SergioPDhe/SergioPico/fabrication/SergioPico_BOM.xlsx

Comment | Designator | Footprint | JLBPCB part #
100n | C1 | Capacitor_SMD:C_0603_1608Metric_Pad1.08x0.95mm_HandSolder | C83060
B5819W | D2 | Diode_SMD:D_SOD-123 | C8598
SS8050 | Q1 | Package_TO_SOT_SMD:SOT-23_Handsoldering | C2150
220 | R1 | Resistor_SMD:R_0603_1608Metric_Pad0.98x0.95mm_HandSolder | C22962
