SergioPDhe/SergioPico/SergioPico_USB/fabrication/USB_BOM.xlsx

Comment | Designator | Footprint | JLBPCB part #
B5819W | D1 | Diode_SMD:D_SOD-123 | C8598
XUNPU TYPEC-1103-BRP24 | J1 | Sergio_footprints:Xunpu C2856665 USBC Straddle Mount | C2856665
5.1k | R1, R2 | Resistor_SMD:R_0603_1608Metric | C23186
