SergioPDhe/SergioPico/Chassis/SergioPico/Rumble.step

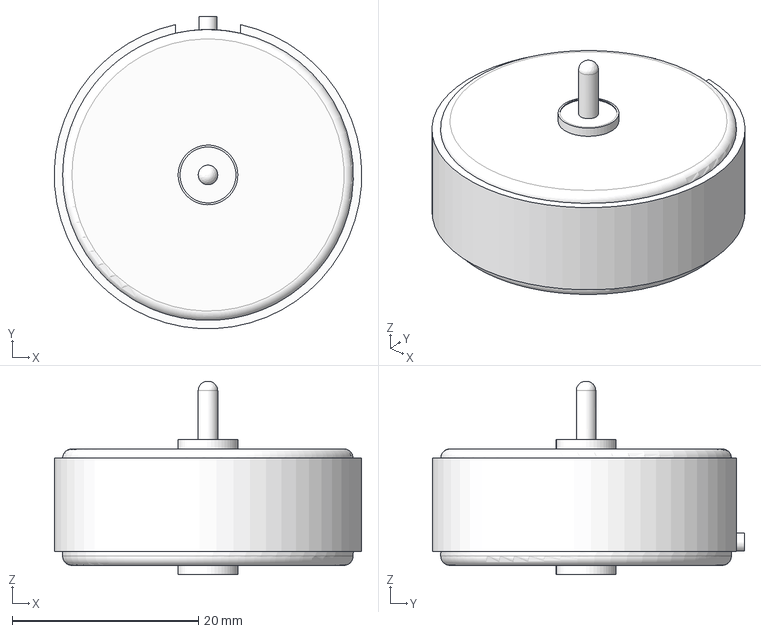
[picture p1: CAD file, 2023-11-24]
Chassis/SergioPico/Rumble.step
33.0 x 33.5 x 20.8 mm
