SergioPDhe/SergioPico/fabrication/keycap_20.5x10_f1_resin.STL

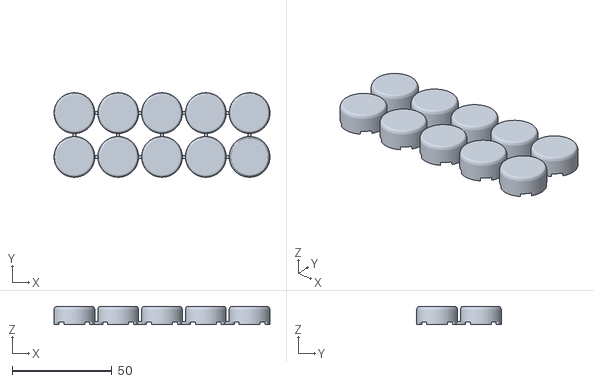
[picture p2: CAD file, 2023-11-24]
fabrication/keycap_20.5x10_f1_resin.STL
108.5 x 42.5 x 9.23
