SergioPDhe/SergioPico/SergioPico_PCB.step

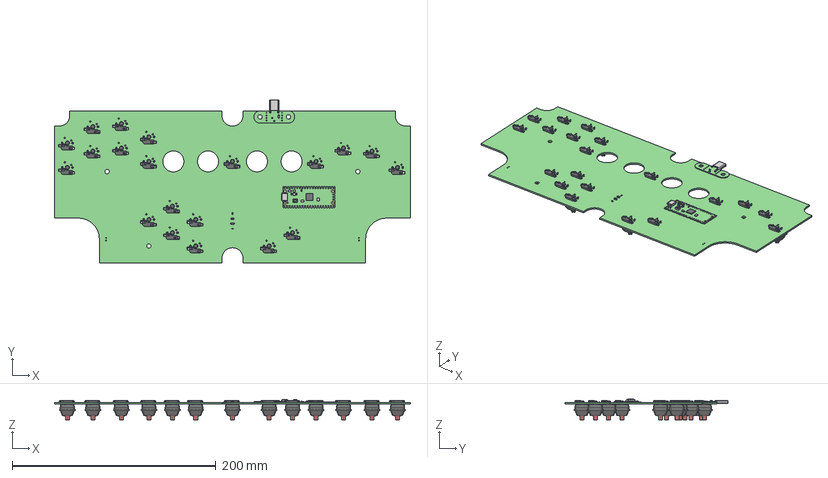
[picture p3: CAD file, 2023-11-24]
SergioPico_PCB.step
349.3 x 159.9 x 20.1 mm
SergioPico PCB
