SergioPDhe/SergioPico/SergioPico_USB/SergioPico_USB.step

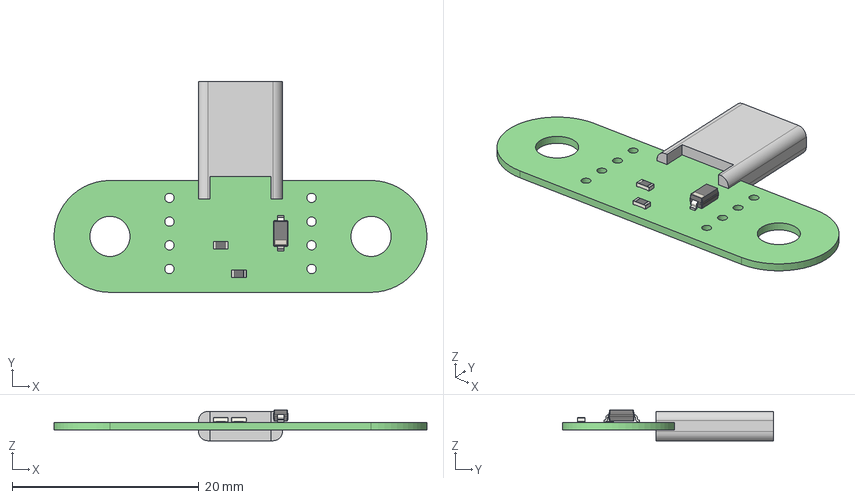
[picture p4: CAD file, 2023-11-24]
SergioPico_USB/SergioPico_USB.step
40.0 x 22.6 x 3.28 mm
SergioPico_USB PCB
