SergioPDhe/SergioPico/Chassis/SergioPico/BL.stl

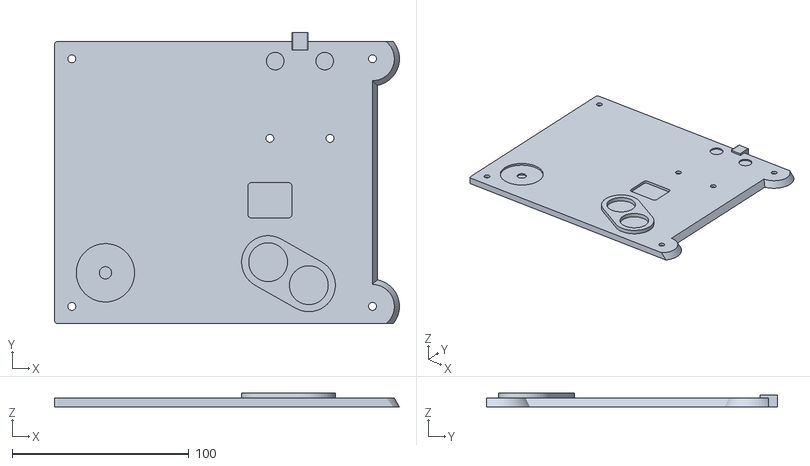
[picture p5: CAD file, 2023-11-24]
Chassis/SergioPico/BL.stl
195.1 x 164.8 x 8.00
