SergioPDhe/SergioPico/Chassis/SergioPico/TM_H.stl

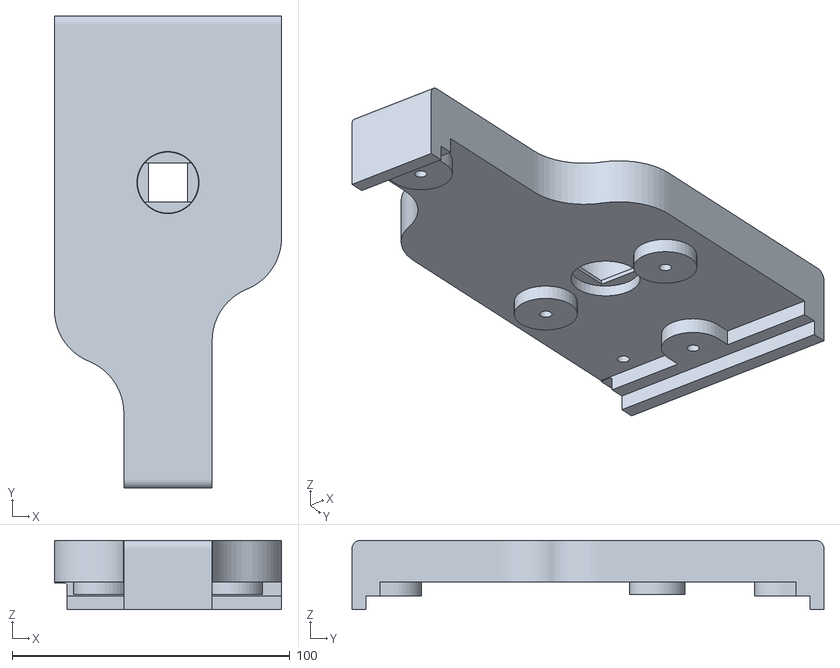
[picture p6: CAD file, 2023-11-24]
Chassis/SergioPico/TM_H.stl
81.8 x 170.0 x 25.0
