SergioPDhe/SergioPico/Chassis/SergioPico/keycap_resin.STL

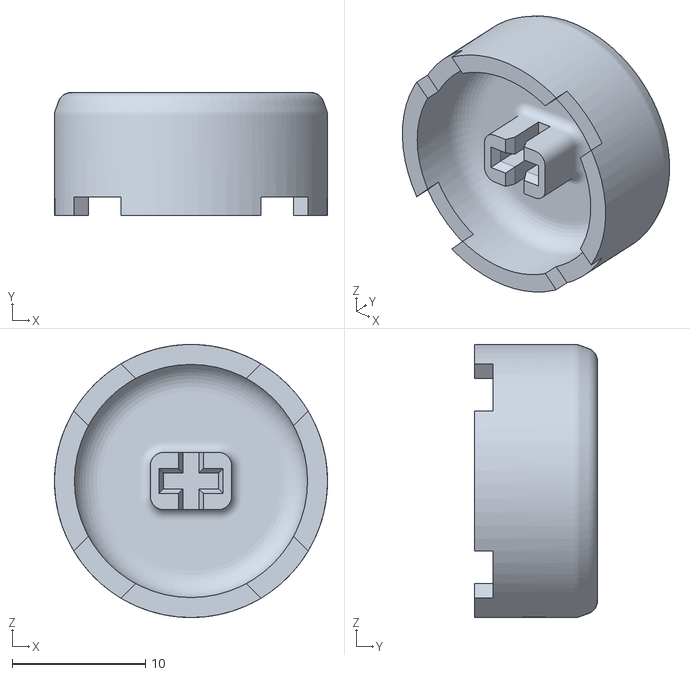
[picture p7: CAD file, 2023-11-24]
Chassis/SergioPico/keycap_resin.STL
20.5 x 9.23 x 20.5
