SergioPDhe/SergioPico/Chassis/SergioPico/TR_NL.stl

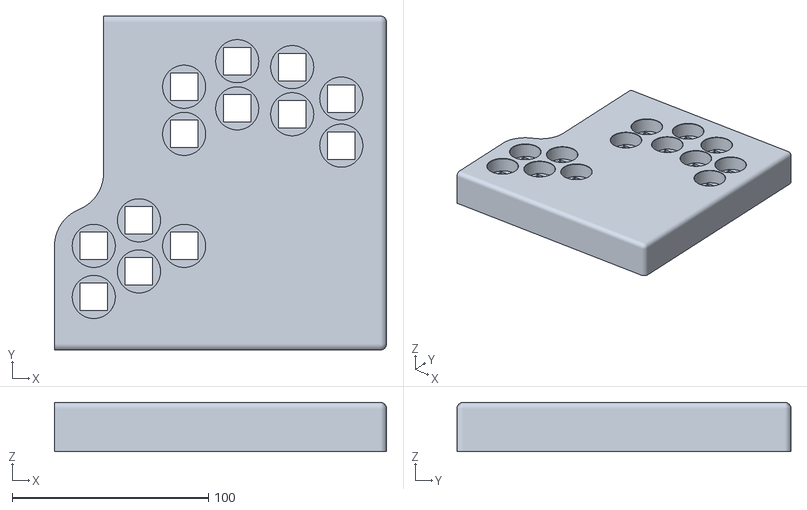
[picture p8: CAD file, 2023-11-24]
Chassis/SergioPico/TR_NL.stl
169.0 x 170.0 x 25.0
