SergioPDhe/SergioPico/Chassis/SergioPico/TL_NL.stl

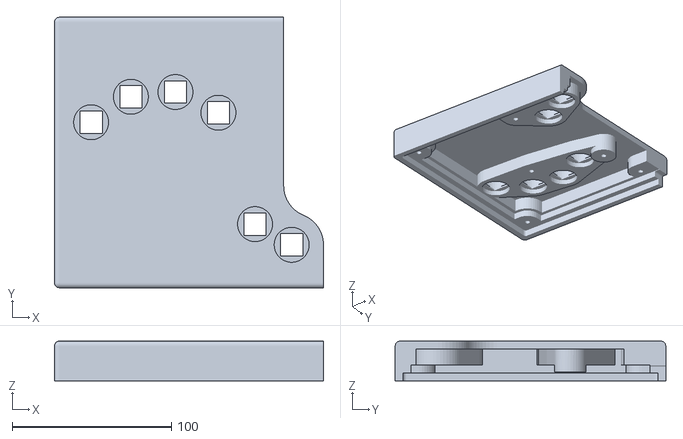
[picture p9: CAD file, 2023-11-24]
Chassis/SergioPico/TL_NL.stl
169.0 x 170.0 x 25.0
