SergioPDhe/SergioPico/Chassis/SergioPico/TR_RL.stl

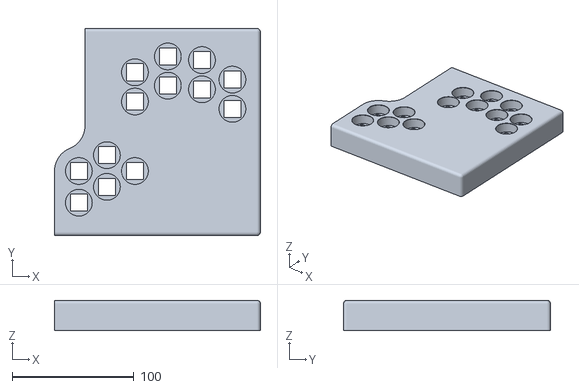
[picture p10: CAD file, 2023-11-24]
Chassis/SergioPico/TR_RL.stl
169.0 x 170.0 x 25.0
