SergioPDhe/SergioPico/Chassis/SergioPico/TL_RL.stl

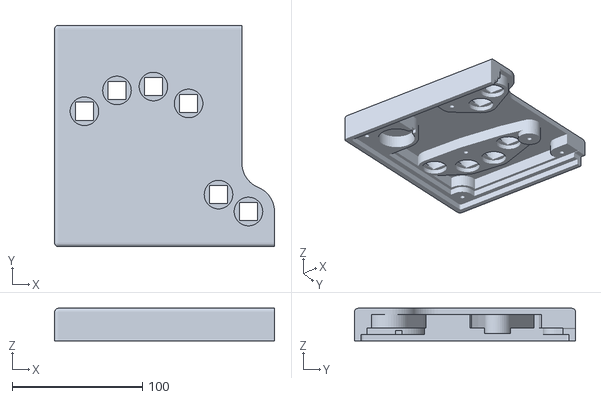
[picture p11: CAD file, 2023-11-24]
Chassis/SergioPico/TL_RL.stl
169.0 x 170.0 x 25.0
