SergioPDhe/SergioPico/Chassis/SergioPico/BR.stl

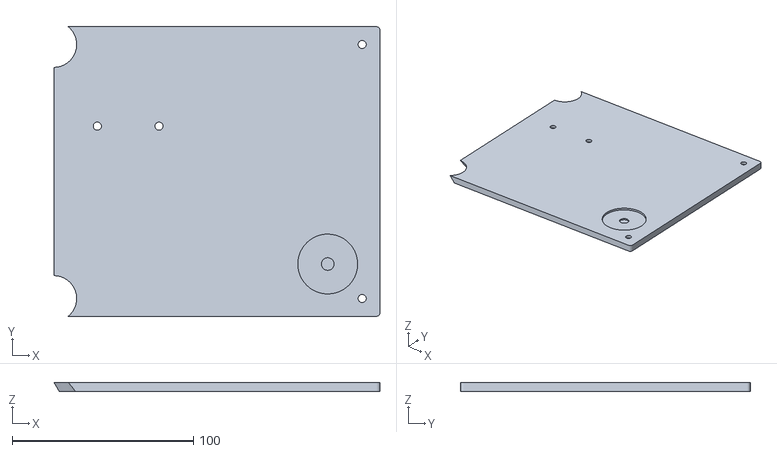
[picture p12: CAD file, 2023-11-24]
Chassis/SergioPico/BR.stl
179.7 x 159.6 x 5.00
