SergioPDhe/SergioPico/Chassis/SergioPico/TL_RH.stl

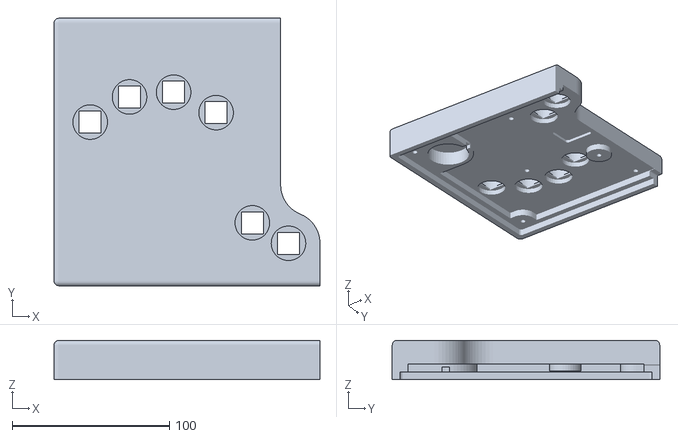
[picture p13: CAD file, 2023-11-24]
Chassis/SergioPico/TL_RH.stl
169.0 x 170.0 x 25.0
