SergioPDhe/SergioPico/(list of files, cad)

Other CAD files:
fabrication/keycap_20.5x10_f1_nylon.STL
Chassis/SergioPico/TM_L.stl
Chassis/SergioPico/TM_Joe.stl
Chassis/SergioPico/TR_RH.stl
Chassis/SergioPico/keycap_nylon.STL
