SergioPDhe/SergioPico/SergioPico_USB/SergioPico_USB.kicad_pcb

## KiCad design SergioPico_USB/SergioPico_USB.kicad_pcb (2023-11-24)

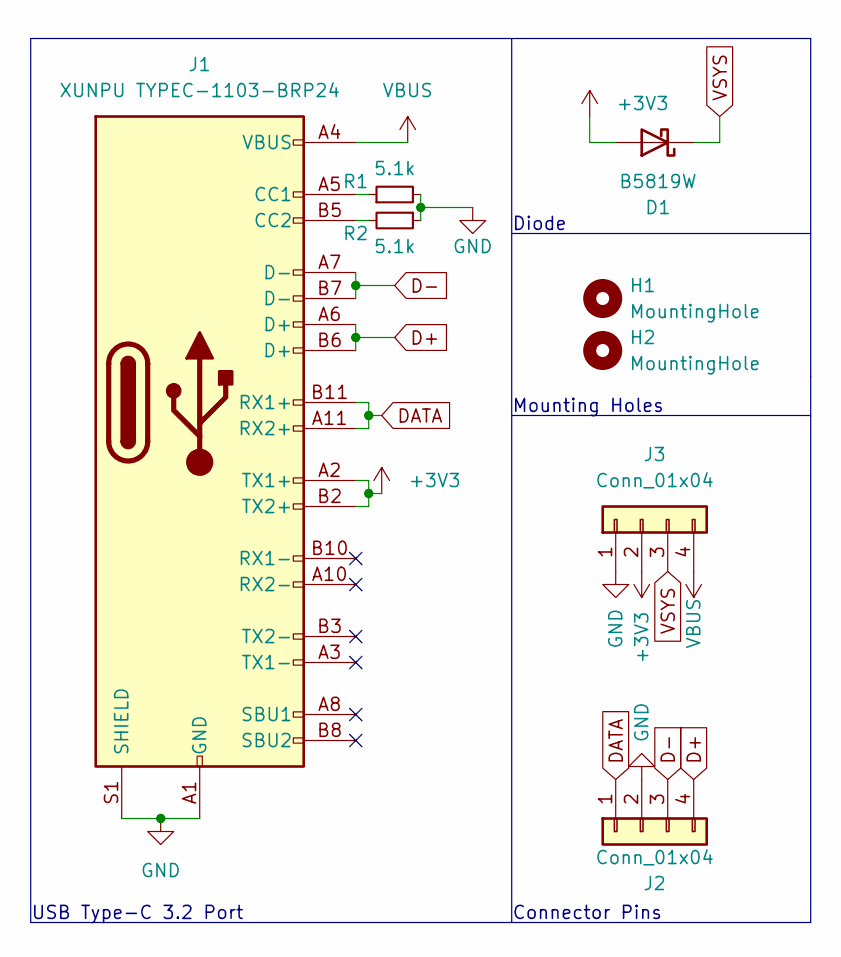
[picture p14: schematic SergioPico_USB.kicad_sch]

Parts:
D1: B5819W; D_SOD-123
H1, H2: MountingHole; MountingHole_4.3mm_M4
J1: XUNPU TYPEC-1103-BRP24; Xunpu C2856665 USBC Straddle Mount
J2, J3: Conn_01x04; PinSocket_1x04_P2.54mm_Vertical
R1, R2: 5.1k; R_0603_1608Metric

Connections:
+3V3: D1.2 (A), J1.A2 (TX1+), J1.B2 (TX2+), J3.2
D+: J1.A6 (D+), J1.B6 (D+), J2.4
D-: J1.A7 (D-), J1.B7 (D-), J2.3
DATA: J1.A11 (RX2+), J1.B11 (RX1+), J2.1
GND: J1.A1 (GND), J1.A12 (GND), J1.B1 (GND), J1.B12 (GND), J1.S1 (SHIELD), J2.2, J3.1, R1.2, R2.1
unnamed: J1.A5 (CC1), R1.1
unnamed: J1.B5 (CC2), R2.2
VBUS: J1.A4 (VBUS), J1.A9 (VBUS), J1.B4 (VBUS), J1.B9 (VBUS), J3.4
VSYS: D1.1 (K), J3.3

Notes on the sheet:
USB Type-C 3.2 Port
Mounting Holes
Connector Pins
Diode

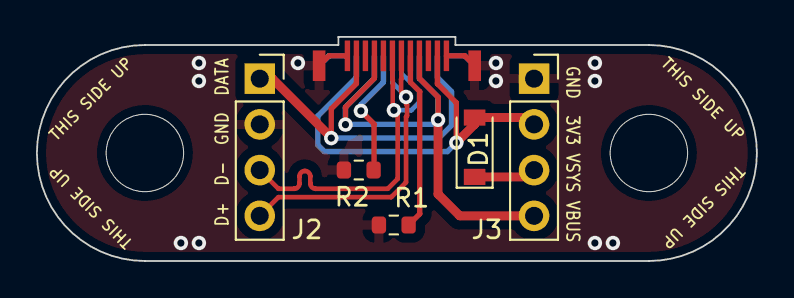
[picture p15: board SergioPico_USB.kicad_pcb from above]

Board: 2 copper layers, 40.0 x 12.5 mm, 8 parts (0 on the bottom side), 9 nets.
