SergioPDhe/SergioPico/SergioPico.kicad_pcb

## KiCad design SergioPico.kicad_pcb (2023-11-24)

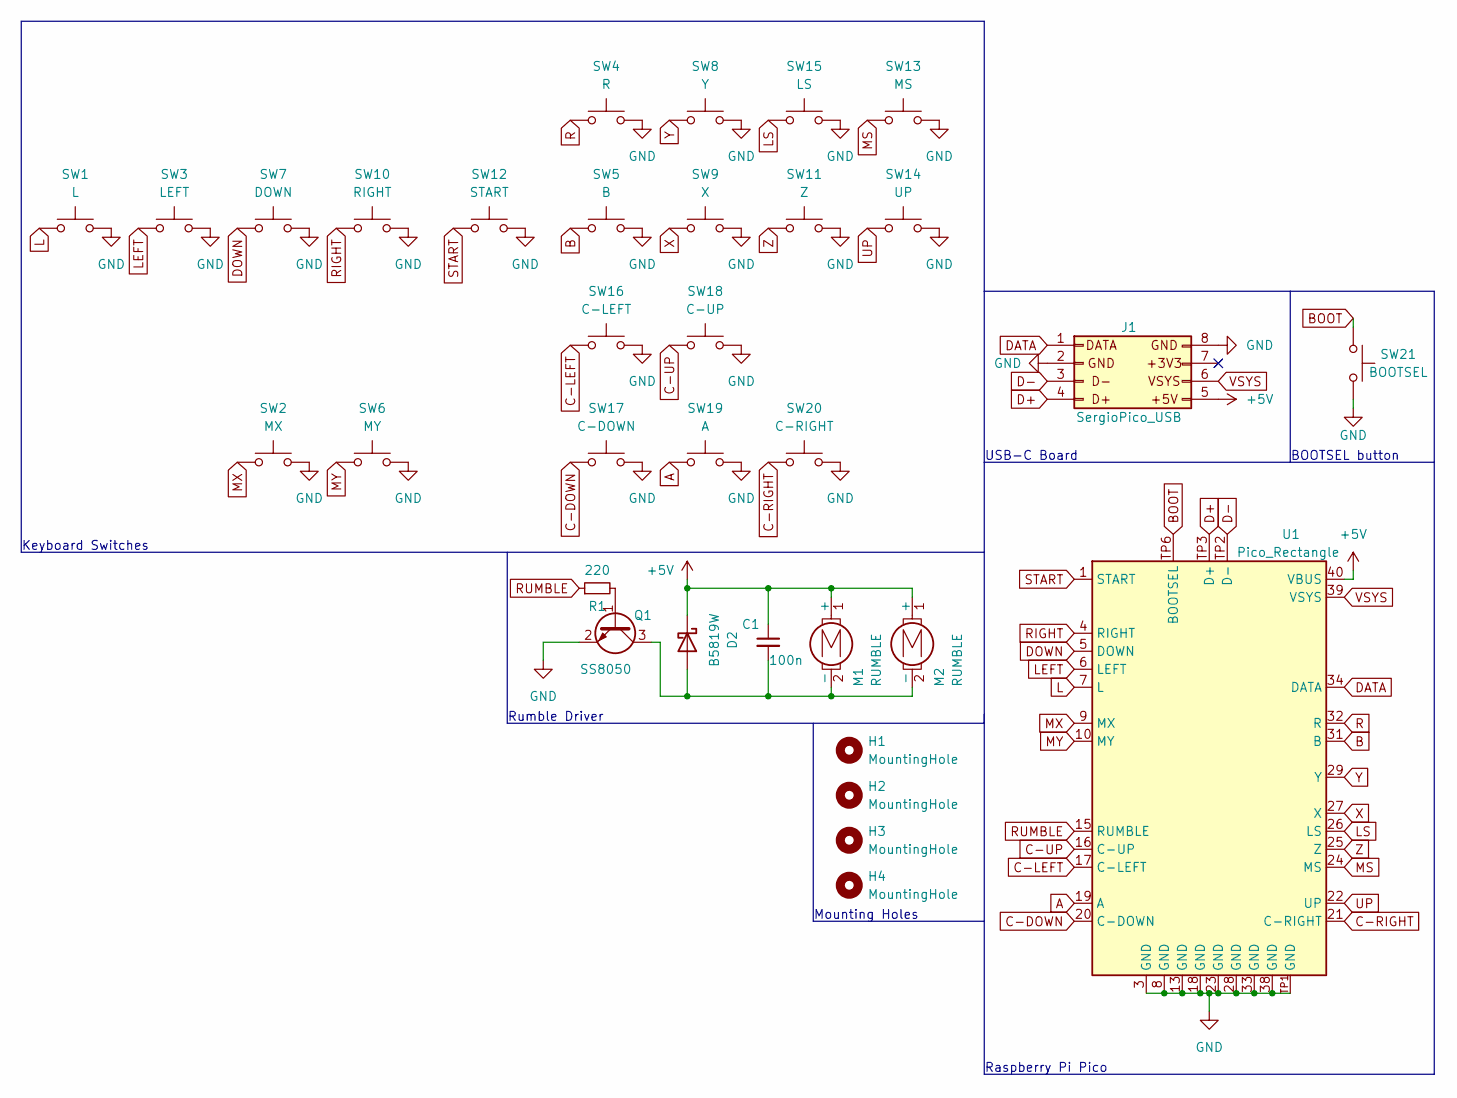
[picture p16: schematic SergioPico.kicad_sch]

Parts:
C1: 100n; C_0402_1005Metric_Pad0.74x0.62mm_HandSolder
D2: B5819W; D_SOD-123
H1, H2, H3, H4: MountingHole; MountingHole_4.3mm_M4
J1: SergioPico_USB
M1, M2: RUMBLE; PinHeader_1x02_P2.54mm_Vertical
Q1: SS8050; SOT-23_Handsoldering
R1: 220; R_0603_1608Metric_Pad0.98x0.95mm_HandSolder
SW1: L; SW_MX_1.00u_PCB_Hybrid
SW2: MX; SW_MX_1.00u_PCB_Hybrid
SW3: LEFT; SW_MX_1.00u_PCB_Hybrid
SW4: R; SW_MX_1.00u_PCB_Hybrid
SW5: B; SW_MX_1.00u_PCB_Hybrid
SW6: MY; SW_MX_1.00u_PCB_Hybrid
SW7: DOWN; SW_MX_1.00u_PCB_Hybrid
SW8: Y; SW_MX_1.00u_PCB_Hybrid
SW9: X; SW_MX_1.00u_PCB_Hybrid
SW10: RIGHT; SW_MX_1.00u_PCB_Hybrid
SW11: Z; SW_MX_1.00u_PCB_Hybrid
SW12: START; SW_MX_1.00u_PCB_Hybrid
SW13: MS; SW_MX_1.00u_PCB_Hybrid
SW14: UP; SW_MX_1.00u_PCB_Hybrid
SW15: LS; SW_MX_1.00u_PCB_Hybrid
SW16: C-LEFT; SW_MX_1.00u_PCB_Hybrid
SW17: C-DOWN; SW_MX_1.00u_PCB_Hybrid
SW18: C-UP; SW_MX_1.00u_PCB_Hybrid
SW19: A; SW_MX_1.00u_PCB_Hybrid
SW20: C-RIGHT; SW_MX_1.00u_PCB_Hybrid
SW21: BOOTSEL; PinHeader_1x02_P2.54mm_Vertical
U1: Pico_Rectangle; RPi_Pico_Removed3Pins

Connections:
+5V: C1.1, D2.1 (K), J1.5, M1.1 (+), M2.1 (+), U1.40 (VBUS)
A: SW19.1, U1.19 (A)
B: SW5.1, U1.31 (B)
BOOT: SW21.1, U1.TP6 (BOOTSEL)
C-DOWN: SW17.1, U1.20 (C-DOWN)
C-LEFT: SW16.1, U1.17 (C-LEFT)
C-RIGHT: SW20.1, U1.21 (C-RIGHT)
C-UP: SW18.1, U1.16 (C-UP)
D+: J1.4, U1.TP3 (D+)
D-: J1.3, U1.TP2 (D-)
DATA: J1.1, U1.34 (DATA)
DOWN: SW7.1, U1.5 (DOWN)
GND: J1.2, J1.8, Q1.2 (E), SW1.2, SW2.2, SW3.2, SW4.2, SW5.2, SW6.2, SW7.2, SW8.2, SW9.2, SW10.2, SW11.2, SW12.2, SW13.2, SW14.2, SW15.2, SW16.2, SW17.2, SW18.2, SW19.2, SW20.2, SW21.2, U1.3 (GND), U1.8 (GND), U1.13 (GND), U1.18 (GND), U1.23 (GND), U1.28 (GND), U1.33 (GND), U1.38 (GND), U1.TP1 (GND)
L: SW1.1, U1.7 (L)
LEFT: SW3.1, U1.6 (LEFT)
LS: SW15.1, U1.26 (LS)
MS: SW13.1, U1.24 (MS)
MX: SW2.1, U1.9 (MX)
MY: SW6.1, U1.10 (MY)
unnamed: C1.2, D2.2 (A), M1.2 (-), M2.2 (-), Q1.3 (C)
unnamed: Q1.1 (B), R1.2
R: SW4.1, U1.32 (R)
RIGHT: SW10.1, U1.4 (RIGHT)
RUMBLE: R1.1, U1.15 (RUMBLE)
START: SW12.1, U1.1 (START)
UP: SW14.1, U1.22 (UP)
VSYS: J1.6, U1.39 (VSYS)
X: SW9.1, U1.27 (X)
Y: SW8.1, U1.29 (Y)
Z: SW11.1, U1.25 (Z)

Notes on the sheet:
USB-C Board
BOOTSEL button
Raspberry Pi Pico
Rumble Driver
Mounting Holes
Keyboard Switches

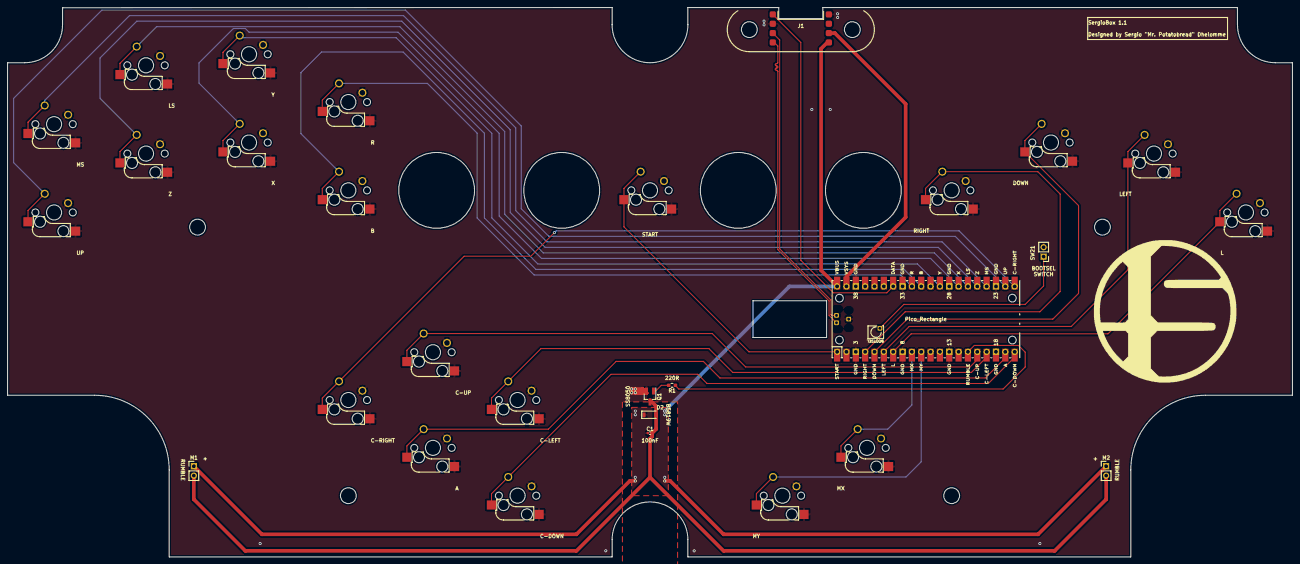
[picture p17: board SergioPico.kicad_pcb from above]

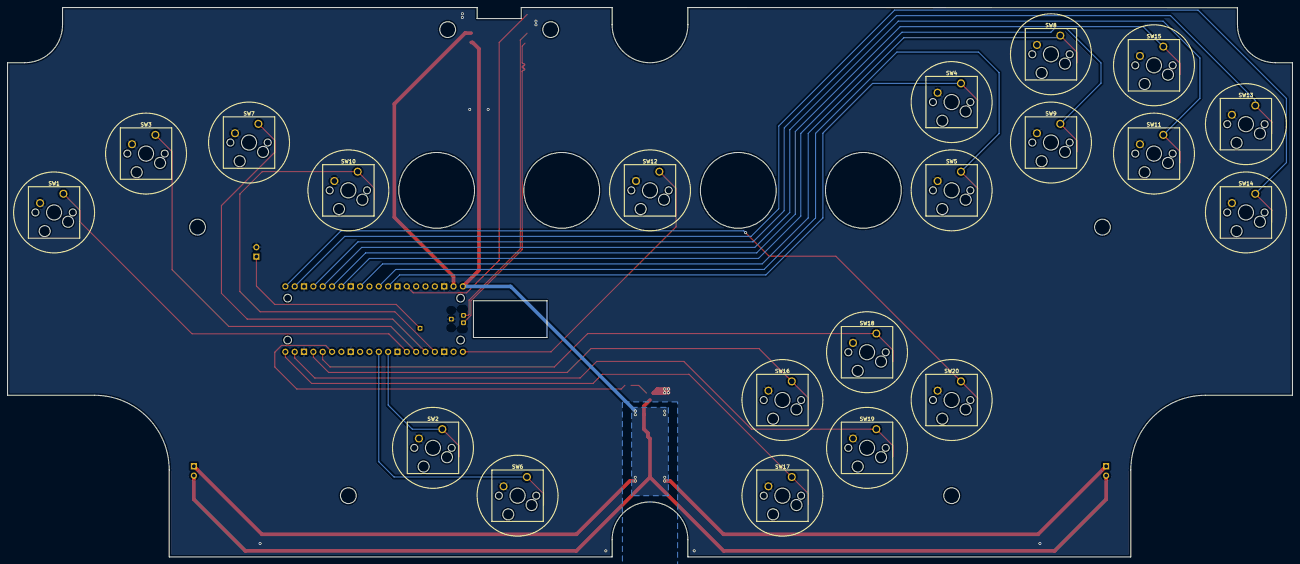
[picture p18: board SergioPico.kicad_pcb from below]

Board: 2 copper layers, 349.3 x 149.4 mm, 33 parts (20 on the bottom side), 30 nets.
