SergioPDhe/SergioPico/(commit log)

2023-11-24 commit of all work done
    [SergioPico-B_Cu.gbr, SergioPico-B_Mask.gbr, SergioPico-B_Paste.gbr, SergioPico-B_Silkscreen.gbr, SergioPico-Edge_Cuts.gbr, SergioPico-F_Cu.gbr, SergioPico-F_Mask.gbr, SergioPico-F_Paste.gbr]
2023-11-24 added models
    [BL.stl, BR.stl, Rumble.step, TL_NL.stl, TL_RH.stl, TL_RL.stl, TM_H.stl, TM_Joe.stl]
